jaysuk/RepRap-Huxley-Vector3D-Edition/Photos/RepRap Huxley V3D24 (21).jpg

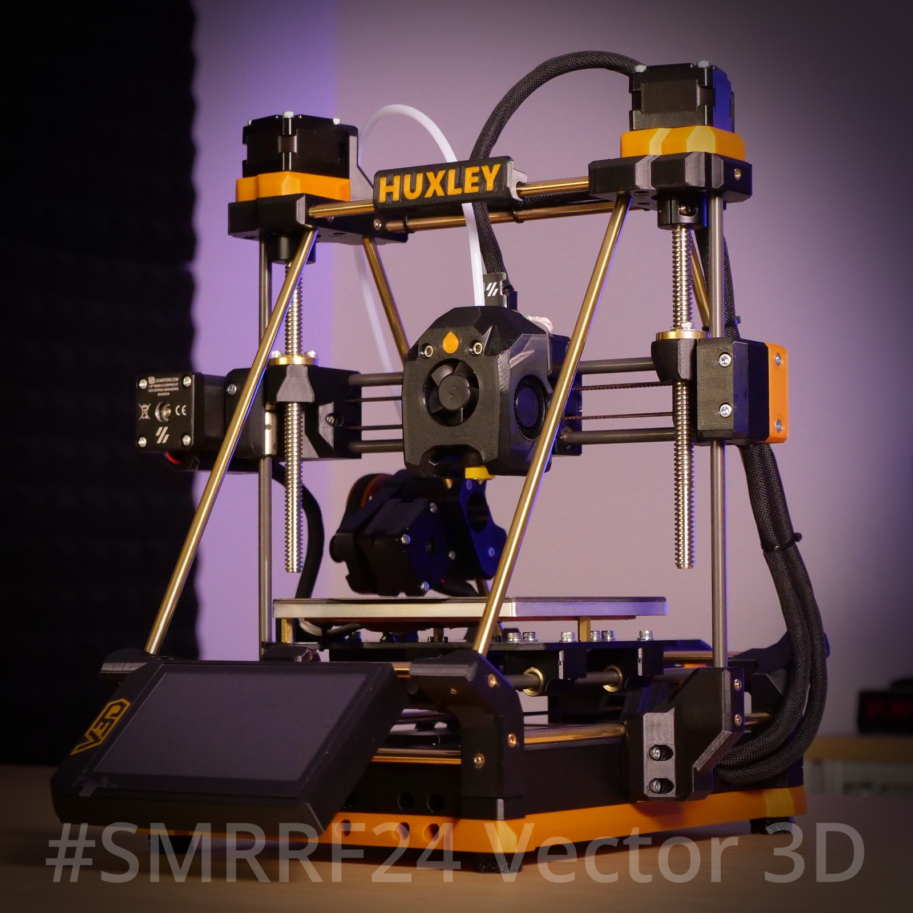
Photos/RepRap Huxley V3D24 (21).jpg
