jaysuk/RepRap-Huxley-Vector3D-Edition/Photos/RepRap Huxley V3D24 (27).jpg

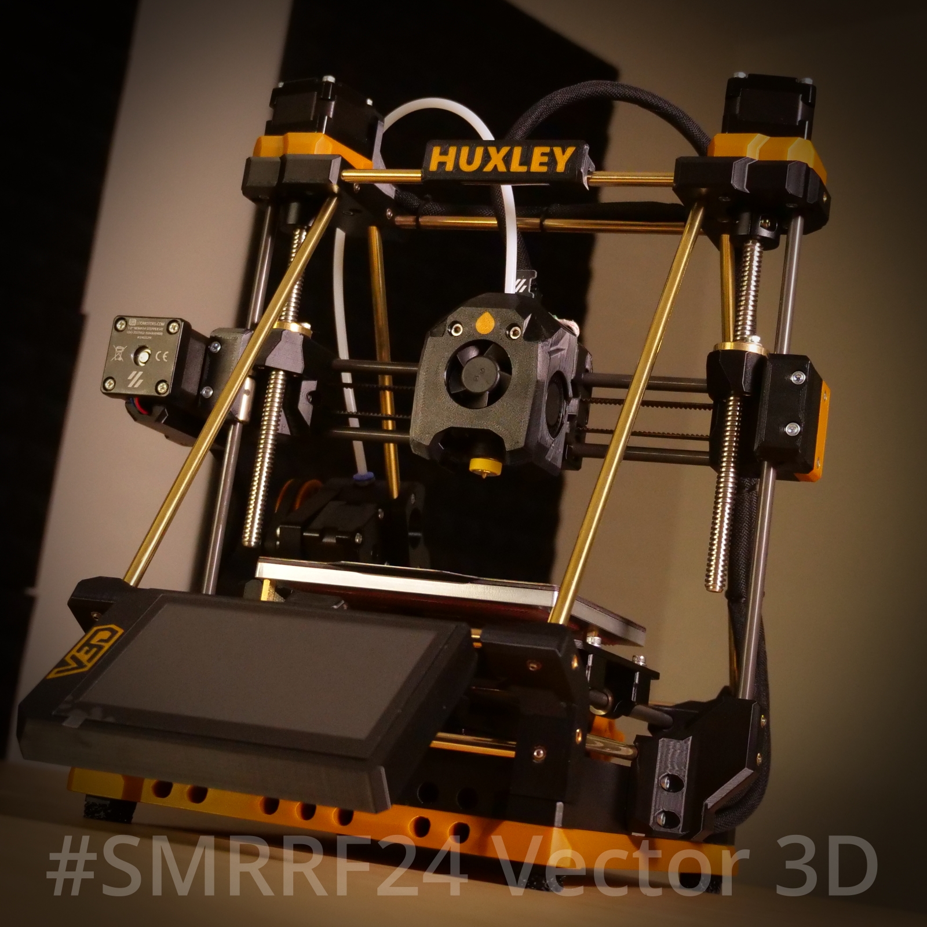
Photos/RepRap Huxley V3D24 (27).jpg
