jaysuk/RepRap-Huxley-Vector3D-Edition/Sourcing BOM/RepRap Huxley BOM GitHub V1.1.xlsx

Sheet: BOM
Index | Assembly | CAD Assembly | Name | Category | UoM | Qty | Link
1 | Printer Frame | Frame Vertex Front | Frame Vertex Front Left | Printed | pcs | 1 | N/A
2 | Printer Frame | Frame Vertex Front | Frame Vertex Front Right | Printed | pcs | 1 | N/A
3 | Printer Frame | Frame Vertex Front | Heat Set Insert, Brass, M3 x 5 x 4 (Vr) | Fastener | pcs | 12 | https://vector3d.shop/products/heat-set-insert-m3-voron
4 | Printer Frame | Frame Vertex Front | Set Screw, Hex Socket, Pointed Cone, Stainless Steel, DIN914, M3 x 6mm | Fastener | pcs | 12 | https://s.click.aliexpress.com/e/_oC1fNpn
5 | Printer Frame | Frame Top | Nema 14 Z Motor Spacer Left | Printed | pcs | 1 | N/A
6 | Printer Frame | Frame Top | Nema 14 Z Motor Spacer Right | Printed | pcs | 1 | N/A
7 | Printer Frame | Frame Top | Frame Vertex Top Left | Printed | pcs | 1 | N/A
8 | Printer Frame | Frame Top | Frame Vertex Top Right | Printed | pcs | 1 | N/A
9 | Printer Frame | Frame Top | Z Wire Cover Left | Printed | pcs | 1 | N/A
10 | Printer Frame | Frame Top | Z Wire Cover Right | Printed | pcs | 1 | N/A
11 | Printer Frame | Frame Top | Heat Set Insert, Brass, M3 x 5 x 4 (Vr) | Fastener | pcs | 12 | https://vector3d.shop/products/heat-set-insert-m3-voron
12 | Printer Frame | Frame Top | Set Screw, Hex Socket, Pointed Cone, Stainless Steel, DIN914, M3 x 6mm | Fastener | pcs | 12 | https://s.click.aliexpress.com/e/_oC1fNpn
13 | Printer Frame | Frame Top | Huxley Nema 14 Z Stepper Motor (see spec) | Bespoke | pcs | 2 | https://s.click.aliexpress.com/e/_oFytERf
14 | Printer Frame | Frame Top | Cable Sleeve, Self Closing, PET, Braided, 5mm | COTS | m | 0.6 | https://s.click.aliexpress.com/e/_oko25xx
15 | Printer Frame | Frame Top | Cable Sleeve, Self Closing, PET, Braided, 5mm | COTS | m | 0.4 | https://s.click.aliexpress.com/e/_oko25xx
16 | Printer Frame | Frame Top | TR8 Lead Screw, 150mm, 8mm Pitch, 2mm Lead, with nut | COTS Hardware | pcs | 2 | https://s.click.aliexpress.com/e/_olyJNbL
17 | Printer Frame | Frame Top | 5x8x25mm Lead Screw Motor Coupler, Black | COTS Hardware | pcs | 2 | https://s.click.aliexpress.com/e/_oDejujf
18 | Printer Frame | Frame Vertex Rear | Frame Vetex Rear Left | Printed | pcs | 1 | N/A
19 | Printer Frame | Frame Vertex Rear | Frame Vertex Rear Right | Printed | pcs | 1 | N/A
20 | Printer Frame | Frame Vertex Rear | Heat Set Insert, Brass, M3 x 5 x 4 (Vr) | Fastener | pcs | 12 | https://vector3d.shop/products/heat-set-insert-m3-voron
21 | Printer Frame | Frame Vertex Rear | Set Screw, Hex Socket, Pointed Cone, Stainless Steel, DIN914, M3 x 6mm | Fastener | pcs | 12 | https://s.click.aliexpress.com/e/_oC1fNpn
22 | Printer Frame | Frame Shafts | Brass rod, 6mm OD, 4mm ID, 176mm | Bespoke | pcs | 6 | https://s.click.aliexpress.com/e/_oCWMqFf
23 | Printer Frame | Frame Shafts | Brass rod, 6mm OD, 4mm ID, 233mm | Bespoke | pcs | 4 | https://s.click.aliexpress.com/e/_oCWMqFf
24 | Printer Frame | Frame Shafts | Brass rod, 6mm OD, 4mm ID, 240mm | Bespoke | pcs | 2 | https://s.click.aliexpress.com/e/_oCWMqFf
25 | Printer Frame | Linear Shafts | Hardened Steel Linear Shaft Rail, 6mm dia, 253mm | COTS Hardware | pcs | 2 | https://s.click.aliexpress.com/e/_oBieFgH
26 | Printer Frame | Linear Shafts | Hardened Steel Linear Shaft Rail, 6mm dia, 220mm | COTS Hardware | pcs | 2 | https://s.click.aliexpress.com/e/_oBieFgH
27 | Printer Frame | Linear Shafts | Hardened Steel Linear Shaft Rail, 6mm dia, 230mm | COTS Hardware | pcs | 2 | https://s.click.aliexpress.com/e/_oBieFgH
28 | Printer Frame | Name Plate | Huxley Name Plate | Printed | pcs | 1 | N/A
29 | Printer Frame | Name Plate | Heat Set Insert, Brass, M3 x 5 x 4 (Vr) | Fastener | pcs | 2 | https://vector3d.shop/products/heat-set-insert-m3-voron
30 | Printer Frame | Name Plate | Set Screw, Hex Socket, Pointed Cone, Stainless Steel, DIN914, M3 x 6mm | Fastener | pcs | 2 | https://s.click.aliexpress.com/e/_oC1fNpn
31 | Printer Frame | Frame Vertex Z Base | Frame Vertex Base Body | Printed | pcs | 2 | N/A
32 | Printer Frame | Frame Vertex Z Base | M3 x 16mm, BHCS, Zinc Plated | Fastener | pcs | 8 | 0
33 | Printer Frame | Frame Vertex Z Base | Heat Set Insert, Brass, M3 x 5 x 4 (Vr) | Fastener | pcs | 4 | https://vector3d.shop/products/heat-set-insert-m3-voron
34 | Printer Frame | Frame Vertex Z Base | Set Screw, Hex Socket, Pointed Cone, Stainless Steel, DIN914, M3 x 6mm | Fastener | pcs | 4 | https://s.click.aliexpress.com/e/_oC1fNpn
35 | Y Axis | Y Bed Assembly | Bed Carriage Plate, Aluminium 6061, Black Matte Anodised, 3mm | Bespoke | pcs | 1 | LDO
36 | Y Axis | Y Bed Assembly | Bed Bearing Holder | Printed | pcs | 4 | N/A
37 | Y Axis | Y Bed Assembly | Bed Bearing Holder Spacer | Printed | pcs | 4 | N/A
38 | Y Axis | Y Bed Assembly | M3 x 16mm, SHCS, Zinc Plated | Fastener | pcs | 12 | Not Applicable
39 | Y Axis | Y Bed Assembly | M3 Washer, Form A, Zinc Plated | Fastener | pcs | 12 | Not Applicable
40 | Y Axis | Y Bed Assembly | Heat Set Insert, Brass, M3 x 5 x 4 (Vr) | Fastener | pcs | 12 | https://vector3d.shop/products/heat-set-insert-m3-voron
41 | Y Axis | Y Bed Assembly | LM6UU Bearing, Graphite Copper, 6x12x19mm | COTS Hardware | pcs | 4 | https://s.click.aliexpress.com/e/_on7sy4t
42 | Y Axis | Y Bed Assembly | Hex Standoff, Female-Female, Brass, M3 x 10mm | Fastener | pcs | 3 | https://s.click.aliexpress.com/e/_ooBX8il
43 | Y Axis | Y Bed Assembly | M3 x 8mm, SHCS, Zinc Plated | Fastener | pcs | 3 | Not Applicable
44 | Y Axis | Y Bed Assembly | M3 x 8mm, BHCS, Zinc Plated | Fastener | pcs | 3 | Not Applicable
45 | Y Axis | Y Bed Assembly | M3 Washer, Form A, Zinc Plated | Fastener | pcs | 3 | Not Applicable
46 | Y Axis | Y Bed Assembly | 120x120x6mm Bed Plate (Voron v0.1) | COTS Hardware | pcs | 1 | LDO
47 | Y Axis | Y Bed Assembly | 100x100mm, Silicone Heater, 60W, 24V, NTC 100k, with adhesive | COTS Electrical | pcs | 1 | https://s.click.aliexpress.com/e/_oCzqo97
48 | Y Axis | Y Bed Assembly | 120x120mm Spring Steel Print Surface with adhesive magnet | COTS Hardware | pcs | 1 | LDO
49 | Y Axis | Y Bed Assembly | Y Belt Holder | Printed | pcs | 1 | N/A
50 | Y Axis | Y Bed Assembly | Y Belt Tensioner | Printed | pcs | 1 | N/A
51 | Y Axis | Y Bed Assembly | M3 x 8mm, SHCS, Zinc Plated | Fastener | pcs | 3 | Not Applicable
52 | Y Axis | Y Bed Assembly | M3 x 12mm, SHCS, Zinc Plated | Fastener | pcs | 2 | Not Applicable
53 | Y Axis | Y Bed Assembly | M3 x 30mm, SHCS, Zinc Plated | Fastener | pcs | 1 | Not Applicable
54 | Y Axis | Y Bed Assembly | M3 Nut, Nyloc, Zinc Plated | Fastener | pcs | 3 | Not Applicable
55 | Y Axis | Y Bed Assembly | 7x7mm Drag Chain Link | COTS Hardware | pcs | 3 | https://s.click.aliexpress.com/e/_oFumcM1
56 | Y Axis | Y Bed Assembly | Y Drag Chain End Bed | Printed | pcs | 1 | N/A
57 | Y Axis | Y Bed Assembly | M3 x 8mm, SHCS, Zinc Plated | Fastener | pcs | 2 | Not Applicable
58 | Y Axis | Chain End B | Y Drag Chain End Frame | Printed | pcs | 1 | N/A
59 | Y Axis | Chain End B | 7x7mm Drag Chain Link | COTS Hardware | pcs | 5 | https://s.click.aliexpress.com/e/_oFumcM1
60 | Y Axis | Chain End B | Heat Set Insert, Brass, M3 x 5 x 4 (Vr) | Fastener | pcs | 1 | https://vector3d.shop/products/heat-set-insert-m3-voron
61 | Y Axis | Chain End B | Set Screw, Hex Socket, Pointed Cone, Stainless Steel, DIN914, M3 x 6mm | Fastener | pcs | 1 | https://s.click.aliexpress.com/e/_oC1fNpn
62 | Y Axis | Y Motor | Huxley Nema 14 Y Stepper Motor (see spec) | Bespoke | pcs | 1 | https://s.click.aliexpress.com/e/_oDsiqIV
63 | Y Axis | Y Motor | Pulley, 20T, Bore 5mm, Belt Width 6mm, Black | COTS Hardware | pcs | 1 | https://s.click.aliexpress.com/e/_oFh7rDn
64 | Y Axis | Y Motor | Belt, 6mm, Gates 2GT | COTS Hardware | m | 0.642 | https://s.click.aliexpress.com/e/_oFIdbGl
65 | Y Axis | Y Motor | Heat Set Insert, Brass, M3 x 5 x 4 (Vr) | Fastener | pcs | 6 | https://vector3d.shop/products/heat-set-insert-m3-voron
66 | Y Axis | Y Motor | Set Screw, Hex Socket, Pointed Cone, Stainless Steel, DIN914, M3 x 6mm | Fastener | pcs | 2 | https://s.click.aliexpress.com/e/_oC1fNpn
67 | Y Axis | Y Motor | M3 x 16mm, SHCS, Zinc Plated | Fastener | pcs | 5 | Not Applicable
68 | Y Axis | Y Motor | M3 x 8mm, SHCS, Zinc Plated | Fastener | pcs | 3 | Not Applicable
69 | Y Axis | Y Motor | Y Motor Mount Front | Printed | pcs | 1 | N/A
70 | Y Axis | Y Motor | Y Motor Mount Back | Printed | pcs | 1 | N/A
71 | Y Axis | Y Motor | Y Motor Mount Cover | Printed | pcs | 1 | N/A
72 | Y Axis | Y Motor | Y Motor Cable Guide | Printed | pcs | 1 | N/A
73 | Y Axis | Y Idler | Y Idler Body | Printed | pcs | 1 | N/A
74 | Y Axis | Y Idler | MF115ZZ 5x11x4mm Flange Bearing | COTS Hardware | pcs | 2 | https://www.aliexpress.com/item/1005008082332408.html?
75 | Y Axis | Y Idler | Heat Set Insert, Brass, M3 x 5 x 4 (Vr) | Fastener | pcs | 2 | https://vector3d.shop/products/heat-set-insert-m3-voron
76 | Y Axis | Y Idler | Set Screw, Hex Socket, Pointed Cone, Stainless Steel, DIN914, M3 x 6mm | Fastener | pcs | 2 | https://s.click.aliexpress.com/e/_oC1fNpn
77 | Y Axis | Y Idler | M5 x 20mm, BHCS, Zinc Plated | Fastener | pcs | 1 | Not Applicable
78 | X Axis | X End, Motor | X End Motor Body | Printed | pcs | 1 | N/A
79 | X Axis | X End, Motor | M3 x 30mm, SHCS, Zinc Plated | Fastener | pcs | 1 | Not Applicable
80 | X Axis | X End, Motor | M3 Nut, Hex, Zinc Plated | Fastener | pcs | 1 | Not Applicable
81 | X Axis | X End, Motor | Huxley Nema 14 X Stepper Motor (see spec) | COTS Electrical | pcs | 1 | https://s.click.aliexpress.com/e/_oDsiqIV
82 | X Axis | X End, Motor | Pulley, 20T, Bore 5mm, Belt Width 6mm, Black | COTS Hardware | pcs | 1 | https://s.click.aliexpress.com/e/_oFh7rDn
83 | X Axis | X End, Motor | M3 x 16mm, SHCS, Zinc Plated | Fastener | pcs | 4 | Not Applicable
84 | X Axis | X End, Motor | Cable Sleeve, Self Closing, PET, Braided, 5mm | COTS Hardware | m | 0.3 | https://s.click.aliexpress.com/e/_oko25xx
85 | X Axis | X End, Motor | X Motor Cable Cover | Printed | pcs | 1 | N/A
86 | X Axis | X End, Motor | M3 x 8mm, SHCS, Zinc Plated | Fastener | pcs | 2 | Not Applicable
87 | X Axis | X End, Motor | X End Bearing Cover Left | Printed | pcs | 1 | N/A
88 | X Axis | X End, Motor | LM6UU Bearing, Graphite Copper, 6x12x19mm | COTS Hardware | pcs | 2 | https://s.click.aliexpress.com/e/_on7sy4t
89 | X Axis | X End, Motor | M3 x 20mm, SHCS, Zinc Plated | Fastener | pcs | 2 | Not Applicable
90 | X Axis | X End, Motor | Lead Screw Nut, TR8, Pitch 2mm (included with lead screw) | COTS Hardware | pcs | 1 | #N/A
91 | X Axis | X End, Motor | M3 x 20mm, SHCS, Zinc Plated | Fastener | pcs | 2 | Not Applicable
92 | X Axis | X End, Motor | Heat Set Insert, Brass, M3 x 5 x 4 (Vr) | Fastener | pcs | 9 | https://vector3d.shop/products/heat-set-insert-m3-voron
93 | X Axis | X End, Motor | Set Screw, Hex Socket, Pointed Cone, Stainless Steel, DIN914, M3 x 6mm | Fastener | pcs | 2 | https://s.click.aliexpress.com/e/_oC1fNpn
94 | X Axis | X End, Motor | Belt, 6mm, Gates 2GT | COTS Hardware | m | 0.56 | https://s.click.aliexpress.com/e/_oFIdbGl
95 | X Axis | X End, Idler | X End Idler Body | Printed | pcs | 1 | N/A
96 | X Axis | X End, Idler | X End Bearing Cover Right | Printed | pcs | 1 | N/A
97 | X Axis | X End, Idler | LM6UU Bearing, Graphite Copper, 6x12x19mm | COTS Hardware | pcs | 2 | https://s.click.aliexpress.com/e/_on7sy4t
98 | X Axis | X End, Idler | M3 x 20mm, SHCS, Zinc Plated | Fastener | pcs | 2 | Not Applicable
99 | X Axis | X End, Idler | Lead Screw Nut, TR8, Pitch 2mm (included with lead screw) | COTS Hardware | pcs | 1 | #N/A
100 | X Axis | X End, Idler | M3 x 20mm, SHCS, Zinc Plated | Fastener | pcs | 2 | Not Applicable
101 | X Axis | X End, Idler | X End Idler Mount | Printed | pcs | 1 | N/A
102 | X Axis | X End, Idler | MF115ZZ 5x11x4mm Flange Bearing | COTS Hardware | pcs | 2 | https://www.aliexpress.com/item/1005008082332408.html?
103 | X Axis | X End, Idler | M5 x 16mm, BHCS, Zinc Plated | Fastener | pcs | 1 | Not Applicable
104 | X Axis | X End, Idler | Heat Set Insert, Brass, M3 x 5 x 4 (Vr) | Fastener | pcs | 8 | https://vector3d.shop/products/heat-set-insert-m3-voron
105 | X Axis | X End, Idler | Set Screw, Hex Socket, Pointed Cone, Stainless Steel, DIN914, M3 x 6mm | Fastener | pcs | 2 | https://s.click.aliexpress.com/e/_oC1fNpn
106 | X Axis | X Carriage | X Carriage Body | Printed | pcs | 1 | N/A
107 | X Axis | X Carriage | X Carriage Lower Bearing Clamp | Printed | pcs | 1 | N/A
108 | X Axis | X Carriage | X Carraige Upper Bearing Clamp | Printed | pcs | 1 | N/A
109 | X Axis | X Carriage | LM6LUU Bearing, Graphite Copper, 6x12x35mm | COTS Hardware | pcs | 1 | https://s.click.aliexpress.com/e/_olb0Hwv
110 | X Axis | X Carriage | LM6UU Bearing, Graphite Copper, 6x12x19mm | COTS Hardware | pcs | 4 | https://s.click.aliexpress.com/e/_on7sy4t
111 | X Axis | X Carriage | M3 Nut, Square, Zinc Plated | COTS Hardware | pcs | 4 | https://s.click.aliexpress.com/e/_olgOr77
112 | X Axis | X Carriage | M3 x 8mm, SHCS, Zinc Plated | Fastener | pcs | 4 | Not Applicable
113 | X Axis | X Carriage | M3 x 12mm, SHCS, Zinc Plated | Fastener | pcs | 4 | Not Applicable
114 | X Axis | X Carriage | Heat Set Insert, Brass, M3 x 5 x 4 (Vr) | Fastener | pcs | 6 | https://vector3d.shop/products/heat-set-insert-m3-voron
115 | X Axis | ToolHead | Huxley Mini SB Bowden Cowling | Printed | pcs | 1 | N/A
116 | X Axis | ToolHead | PTFE Tube, 4mm OD, 2mm ID, 32mm | COTS Hardware | m | 0.032 | https://s.click.aliexpress.com/e/_omdtdiv
117 | X Axis | ToolHead | Poke Probe | Printed | pcs | 1 | N/A
118 | X Axis | ToolHead | Poke Spacer | Printed | pcs | 1 | N/A
119 | X Axis | ToolHead | Set Screw, Hex Socket, Flat, Stainless Steel, DIN914, M3 x 4mm | Fastener | pcs | 4 | https://s.click.aliexpress.com/e/_oDxamSl
120 | X Axis | ToolHead | Wire, PTFE, 24AWG, 100mm | COTS Electrical | m | 0.1 | https://s.click.aliexpress.com/e/_opigOOV
121 | X Axis | ToolHead | MiniSB Bowden Toolhead PCB | COTS Electrical | pcs | 1 | Custom PCB
122 | X Axis | ToolHead | MiniSB Umbilical Wire Harness (see Specs) | Bespoke | pcs | 1 | Custom Wire Harness
123 | X Axis | ToolHead | M2 x 10mm, SHCS, Self Tapping | Fastener | pcs | 2 | https://s.click.aliexpress.com/e/_oocZ1fT
124 | X Axis | ToolHead | M3 x 35mm, BHCS, Zinc Plated | Fastener | pcs | 2 | Not Applicable
125 | X Axis | ToolHead | ECAS04 Bowden Collet | COTS Hardware | pcs | 1 | https://s.click.aliexpress.com/e/_oCLUYq9
126 | X Axis | ToolHead | 3010 DC Axial Fan (voron v0 spec) | COTS Electrical | pcs | 1 | https://s.click.aliexpress.com/e/_onlr0cv
127 | X Axis | ToolHead | 3010 DC Radial Blower Fan (voron v0 spec) | COTS Electrical | pcs | 2 | https://s.click.aliexpress.com/e/_onlr0cv
128 | X Axis | ToolHead | TZ-V6-2.0 | COTS Electrical | pcs | 1 | 0
129 | Extruder | Mini-14 Mirrored | Mini14 Main Body Mid Section | Printed | pcs | 1 | N/A
130 | Extruder | Mini-14 Mirrored | Mini14 Main Body End Plate | Printed | pcs | 1 | N/A
131 | Extruder | Mini-14 Mirrored | Mini14 Main Body Motor Plate | Printed | pcs | 1 | N/A
132 | Extruder | Mini-14 Mirrored | Mini14 Main Body Clamp | Printed | pcs | 1 | N/A
133 | Extruder | Mini-14 Mirrored | Huxley Nema 14 E Stepper Motor (see spec) | Bespoke | pcs | 1 | https://s.click.aliexpress.com/e/_oFytERf
134 | Extruder | Mini-14 Mirrored | Pulley, 16T, Bore 5mm, Belt Width 6mm, Black | COTS Hardware | pcs | 2 | https://s.click.aliexpress.com/e/_oodzRYH
135 | Extruder | Mini-14 Mirrored | M3 x 12mm, BHCS, Zinc Plated | Fastener | pcs | 2 | Not Applicable
136 | Extruder | Mini-14 Mirrored | M3 x 10mm, SHCS, Zinc Plated | Fastener | pcs | 1 | Not Applicable
137 | Extruder | Mini-14 Mirrored | M3 x 30mm, SHCS, Zinc Plated | Fastener | pcs | 4 | Not Applicable
138 | Extruder | Mini-14 Mirrored | ECAS04 Bowden Collet | COTS Hardware | pcs | 1 | https://s.click.aliexpress.com/e/_oCLUYq9
139 | Extruder | Mini-14 Mirrored | Heat Set Insert, Brass, M3 x 5 x 4 (Vr) | Fastener | pcs | 7 | https://vector3d.shop/products/heat-set-insert-m3-voron
140 | Extruder | Mini-14 Mirrored | Mini14 Latch | Printed | pcs | 1 | N/A
141 | Extruder | Mini-14 Mirrored | Mini14 Guidler | Printed | pcs | 1 | N/A
142 | Extruder | Mini-14 Mirrored | Mini14 Shuttle | Printed | pcs | 1 | N/A
143 | Extruder | Mini-14 Mirrored | PTFE Tube, 4mm OD, 2mm ID, 32mm | COTS Hardware | m | 0.032 | https://s.click.aliexpress.com/e/_omdtdiv
144 | Extruder | Mini-14 Mirrored | Bondtech Driver Gear and Idler | COTS Hardware | pcs | 1 | https://s.click.aliexpress.com/e/_oECa5HP
145 | Extruder | Mini-14 Mirrored | Bondtech Extruder Spring Set | COTS Hardware | pcs | 1 | https://s.click.aliexpress.com/e/_ontUa5L
146 | Extruder | Mini-14 Mirrored | Bondtech Extruder Shaft | COTS Hardware | pcs | 1 | https://s.click.aliexpress.com/e/_o2aOLXF
147 | Extruder | Mini-14 Mirrored | Mini14 Guidler | Printed | pcs | 1 | N/A
148 | Extruder | Mini-14 Mirrored | M3 x 8mm, SHCS, Zinc Plated | Fastener | pcs | 2 | Not Applicable
149 | Extruder | Mini-14 Mirrored | GT2 Belt, Loop, 6mm width, 150mm | COTS Hardware | pcs | 1 | https://s.click.aliexpress.com/e/_olMfmXP
150 | Extruder | Mini-14 Mirrored | 64T Front Pullet Gear | Printed | pcs | 1 | N/A
151 | Extruder | Mini-14 Mirrored | Set Screw, Hex Socket, Pointed Cone, Stainless Steel, DIN914, M3 x 6mm | Fastener | pcs | 4 | https://s.click.aliexpress.com/e/_oC1fNpn
152 | Extruder | Mini-14 Mirrored | D-Shaft, Steel, 5mm dia, 50mm Length | COTS Hardware | pcs | 1 | https://s.click.aliexpress.com/e/_oDKDjFb
153 | Extruder | Mini-14 Mirrored | Spacer, 3mm | Printed | pcs | 1 | N/A
154 | Extruder | Mini-14 Mirrored | Spacer, 3.8mm | Printed | pcs | 1 | N/A
155 | Extruder | Mini-14 Mirrored | F6952RS, Flange Bearing, 5x13x4mm | COTS Hardware | pcs | 2 | https://s.click.aliexpress.com/e/_okQcUI9
156 | Extruder | Mini-14 Mirrored | Cable Sleeve, Self Closing, PET, Braided, 5mm | COTS Hardware | m | 0.2 | https://s.click.aliexpress.com/e/_oko25xx
157 | Electronics Enclosure | Electronics Enclosure | Enclosure Upper | Printed | pcs | 1 | N/A
158 | Electronics Enclosure | Electronics Enclosure | Heat Set Insert, Brass, M3 x 5 x 4 (Vr) | Fastener | pcs | 8 | https://vector3d.shop/products/heat-set-insert-m3-voron
159 | Electronics Enclosure | Electronics Enclosure | Enclosure Lower | Printed | pcs | 1 | N/A
160 | Electronics Enclosure | Electronics Enclosure | M3 x 12mm, SHCS, Zinc Plated | Fastener | pcs | 8 | Not Applicable
161 | Electronics Enclosure | Electronics Enclosure | Y Motor Passthough Upper | Printed | pcs | 1 | N/A
162 | Electronics Enclosure | Electronics Enclosure | Y Motor Passthough Lower | Printed | pcs | 1 | N/A
163 | Electronics Enclosure | Electronics Enclosure | Extruder Passthough | Printed | pcs | 1 | N/A
164 | Electronics Enclosure | Electronics Enclosure | Z Motor Passthrough | Printed | pcs | 1 | N/A
165 | Electronics Enclosure | Electronics Enclosure | Bed Passthrough | Printed | pcs | 1 | N/A
166 | Electronics Enclosure | Electronics Enclosure | M3 x 12mm, SHCS, Zinc Plated | Fastener | pcs | 7 | Not Applicable
167 | Electronics Enclosure | Electronics Enclosure | Hex Foot | Printed | pcs | 4 | N/A
168 | Electronics Enclosure | Electronics Enclosure | M3 x 12mm, SHCS, Zinc Plated | Fastener | pcs | 4 | Not Applicable
169 | Electronics Enclosure | Electronics Enclosure | 4010 Radial Fan, 24V | COTS Electrical | pcs | 2 | https://s.click.aliexpress.com/e/_oFncEMt
170 | Electronics Enclosure | Electronics Enclosure | M3 x 6mm, SHCS, Self Tapping | Fastener | pcs | 8 | Not Applicable
171 | Electronics Enclosure | Electronics Enclosure | 4010 Axial Fan, 24V | COTS Electrical | pcs | 1 | https://s.click.aliexpress.com/e/_oFncEMt
172 | Electronics Enclosure | Electronics Enclosure | M3 x 10mm, SHCS, Self Tapping | Fastener | pcs | 4 | https://s.click.aliexpress.com/e/_ooSIUhT
173 | Electronics Enclosure | Electronics Enclosure | Rocker Switch, KCD1, 4 Pin, Black | COTS Electrical | pcs | 1 | https://s.click.aliexpress.com/e/_okNm3VJ
174 | Electronics Enclosure | Electronics Enclosure | Spade Terminal, Female | COTS Electrical | pcs | 4 | https://s.click.aliexpress.com/e/_oCGcb8d
175 | Electronics Enclosure | Electronics Enclosure | Power Connector, KYCON, KPJX-PM-4 | COTS Electrical | pcs | 1 | https://www.mouser.co.uk/ProductDetail/Kycon/KPJX-PM-4S?qs=zorda86t5M%2Fdp%252BTtr6by2g%3D%3D
176 | Electronics Enclosure | Electronics Enclosure | ST2.9 x 13 Screw | Fastener | pcs | 2 | https://s.click.aliexpress.com/e/_o2DYvLb
177 | Electronics Enclosure | Electronics Enclosure | RJ45 Keystone | COTS Electrical | pcs | 1 | https://s.click.aliexpress.com/e/_olKKrjj
178 | Electronics Enclosure | Electronics Enclosure | Ethernet Cable, Flexible, 200mm | COTS Electrical | pcs | 1 | https://s.click.aliexpress.com/e/_oFH9p61
179 | Electronics Enclosure | Electronics Enclosure | JST XH 5-way Hub | COTS Electrical | pcs | 1 | Custom PCB
180 | Electronics Enclosure | Electronics Enclosure | M3 x 8mm, SHCS, Self Tapping | Fastener | pcs | 2 | https://s.click.aliexpress.com/e/_oE11vDB
181 | Electronics Enclosure | Electronics Enclosure | BigtreeTech SKR Pico | COTS Electrical | pcs | 1 | BigTreeTech
183 | Electronics Enclosure | Electronics Enclosure | Raspberry Pi Zero 2W | COTS Electrical | pcs | 1 | https://thepihut.com/products/raspberry-pi-zero-2?variant=41181426909379
184 | Electronics Enclosure | Electronics Enclosure | Connector Cover | Printed | pcs | 1 | N/A
185 | Electronics Enclosure | Electronics Enclosure | M2 x 6mm, SHCS, Self Tapping | Fastener | pcs | 2 | https://s.click.aliexpress.com/e/_oocZ1fT
0 | Electronics Enclosure | Electronics Enclosure | Switch Harness (See Specs) | Bespoke | pcs | 1 | #N/A
0 | Electronics Enclosure | Electronics Enclosure | Power Harness 1 (See Specs) | Bespoke | pcs | 1 | #N/A
0 | Electronics Enclosure | Electronics Enclosure | Power Harness 2 (See Specs) | Bespoke | pcs | 1 | #N/A
186 | Power | Power Supply | Power Supply, External, EA11811k-240 | COTS Electrical | pcs | 1 | 0
187 | Toolkit | Toolkit | 1.5mm Hex for M3 set screws | COTS Hardware | pcs | 1 | #N/A
188 | Toolkit | Toolkit | 2.5mm Hex for M3 SHCS | COTS Hardware | pcs | 1 | #N/A
189 | Toolkit | Toolkit | 2.0mm Hex for M3 BHCS | COTS Hardware | pcs | 1 | #N/A
190 | Toolkit | Toolkit | Locktite | COTS Hardware | pcs | 1 | #N/A
191 | Toolkit | Toolkit | Steel Wool | COTS Hardware | pcs | 1 | #N/A
192 | Toolkit | Toolkit | Zip Ties, 2.5 x 100mm | COTS Hardware | pcs | 100 | #N/A

Sheet: Custom Specifications
Name | Model | Face | Body Length mm (approx) | Wire Length mm | Connector | Shaft Diameter | Shaft Length (from mounting face) | Shaft Type | Step Angle | Wire Connection
Z Left Motor | 14HS11-1004S | Nema14 | 26.6 | 480 | JST XH 4P | 5 | 24 | D | 1.8 | Direct into Body
Z Right Motor | 14HS11-1004S | Nema14 | 26.6 | 605 | JST XH 4P | 5 | 24 | D | 1.8 | Direct into Body
X Motor | 35STH52-1504AH | Nema14 | 50.8 | 450 | JST XH 4P | 5 | 19 (+5/ -0) | D | 1.8 | Direct into Body
Y Motor | 35STH52-1504AH | Nema14 | 50.8 | 200 | JST XH 4P | 5 | 19 (+5/ -0) | D | 1.8 | Direct into Body
E0 Motor | 14HS11-1004S | Nema14 | 26.6 | 250 | JST XH 4P | 5 | 18 (+8/-0) | D | 1.8 | Direct into Body
Harness | End A | Pin Number A | Pin Name | Function | Length (mm) | Wire Gauge | Wire Type | Wire Colour | EndB
MiniSB Umbilical | Microfit 3.0 2x4 | 1 | 24V | 24V Power | 740 | 24 | PTFE/FEP | Black | Ferrule
MiniSB Umbilical | Microfit 3.0 2x4 | 2 | PCF | Part Cooling Fan | 700 | 24 | PTFE/FEP | Black | JST XH 2P
MiniSB Umbilical | Microfit 3.0 2x4 | 3 | GND | Ground | 740 | 24 | PTFE/FEP | Black | Ferrule
MiniSB Umbilical | Microfit 3.0 2x4 | 4 | TH0 | Thermistor | 760 | 24 | PTFE/FEP | Black | JST XH 2P
MiniSB Umbilical | Microfit 3.0 2x4 | 5 | HEF | Hotend Fan | 700 | 24 | PTFE/FEP | Black | JST XH 2P
MiniSB Umbilical | Microfit 3.0 2x4 | 6 | 5V | 5V Power | 760 | 24 | PTFE/FEP | Black | cut wire/not used
MiniSB Umbilical | Microfit 3.0 2x4 | 7 | LED | LED Signal | 760 | 24 | PTFE/FEP | Black | cut wire/not used
MiniSB Umbilical | Microfit 3.0 2x4 | 8 | HE0 | Hotend | 740 | 24 | PTFE/FEP | Black | Ferrule
Power 1 | KPJX-PM-4 | 1 | +VE | 24V Power | 220 | 18 | PVC | Red | Stripped 10mm for WAGO
Power 1 | KPJX-PM-4 | 2 | -VE | Ground | 185 | 18 | PVC | Black | Stripped 10mm for WAGO
Power 1 | KPJX-PM-4 | 3 | -VE | Ground | 185 | 18 | PVC | Black | Stripped 10mm for WAGO
Power 1 | KPJX-PM-4 | 4 | +VE | 24V Power | 220 | 18 | PVC | Red | Stripped 10mm for WAGO
Power 2 | Stripped 10mm for WAGO | 1 | -VE | Ground | 115 | 18 | PVC | Black | Ferrule
Switch | Switch | 1 | +VE | 24V Power | 70 | 18 | PVC | Red | Stripped 10mm for WAGO
Switch | Switch | 2 | +VE | 24V Power | 150 | 18 | PVC | Red | Ferrule
Name | Thickness (mm) | Material | Finish | Width (mm) | Length (mm)
Bed Carriage Plate | 3 | 6061 Aluminium | Anodised Black | 158 | 120
