jaysuk/RepRap-Huxley-Vector3D-Edition/Full CAD/RepRapPro Huxley Assembled.step

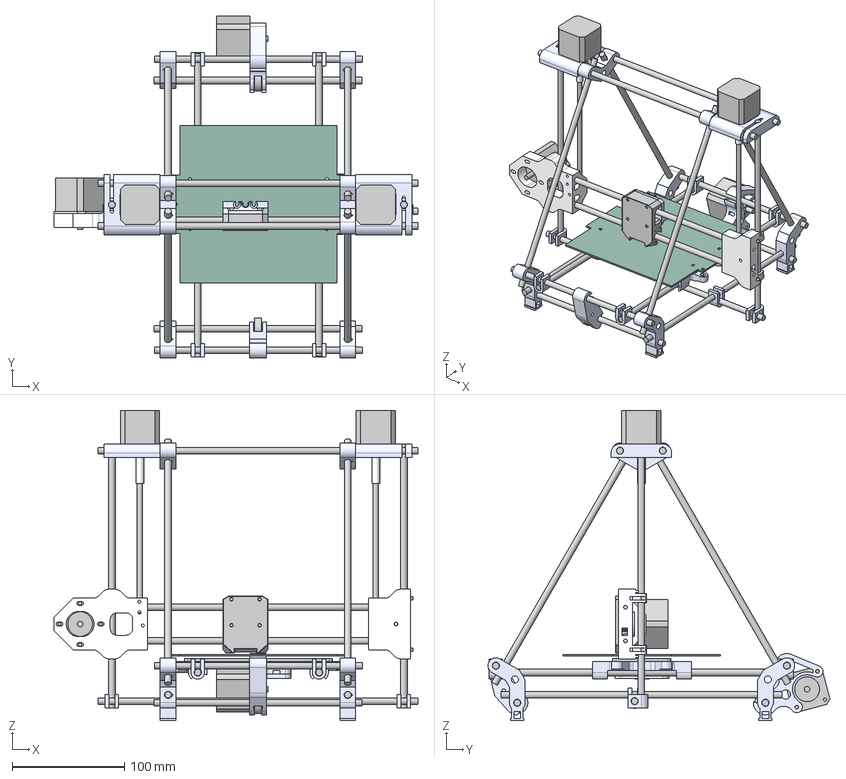
[picture p29: CAD file, 2026-03-26]
Full CAD/RepRapPro Huxley Assembled.step
324.0 x 304.5 x 276.4 mm
frame-vertex x 2
frame-vertex-foot x 4
bar-clamp x 8
626 Bearing x 2
z-motor-bracket x 2
Y Frog
bearing-holder-float
bearing-holder-fixed
y-belt-clamp x 2
y-belt-tensioner
Nema14 x 4
y-motor-bracket
y-idler-bracket
623 Bearing x 2
x-idler-bracket
x-motor-bracket
nozzle-mounting
idler-cover
x-carriage
PolyTube x 2
M5 165mm x 2
Huxley PCB Heater
