jaysuk/RepRap-Huxley-Vector3D-Edition/Drawings 2D/Y Axis Bed Plate Drawing v3.pdf

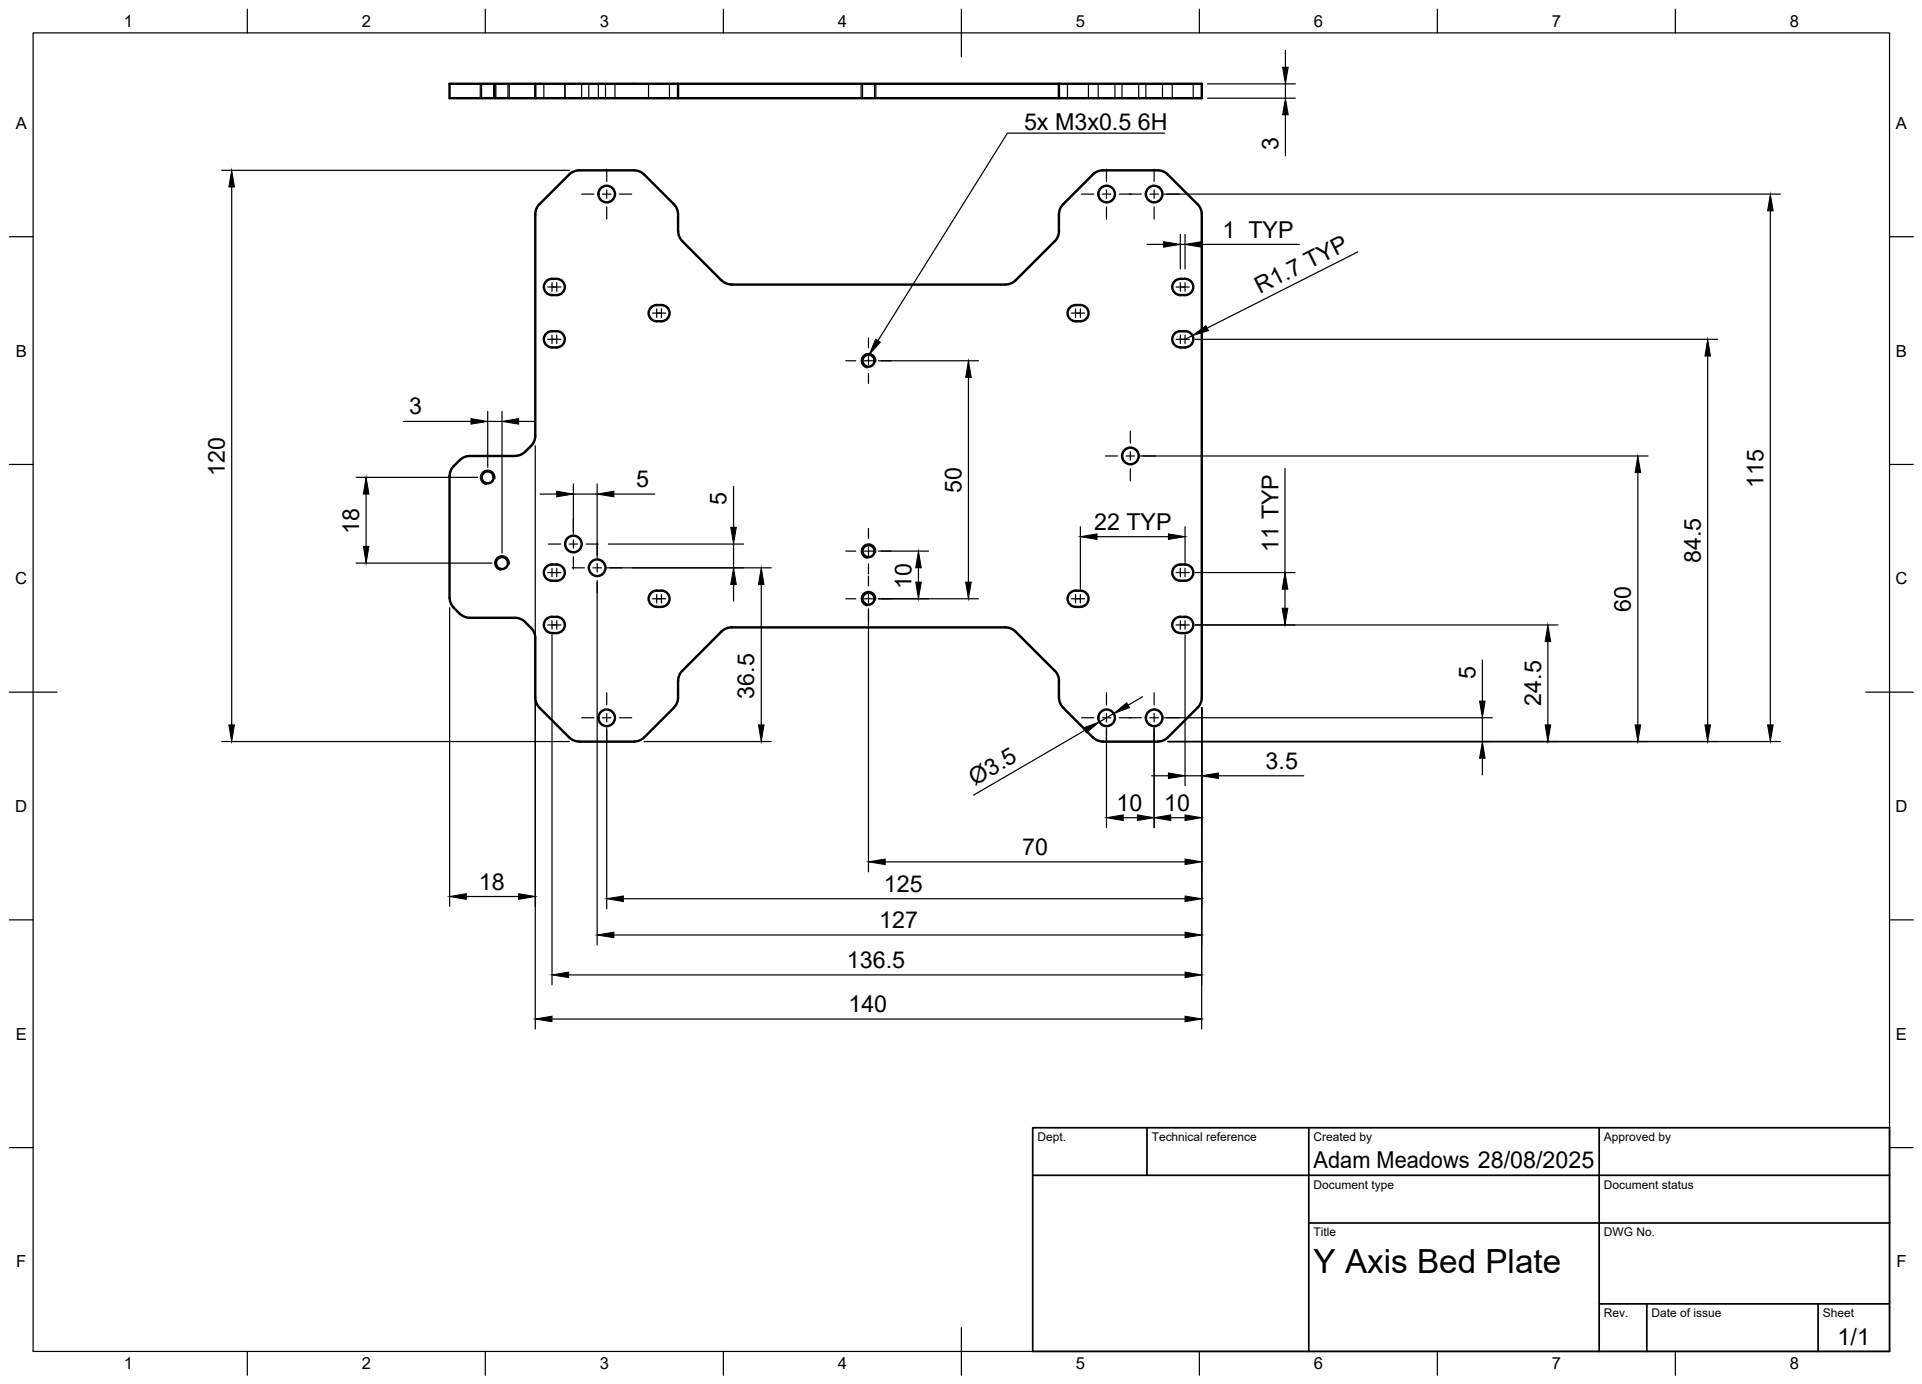
[picture p30: page 1]
Title; DWG No.; Rev.; Date of issue; Sheet; 5 24.5 60 84.5 11 TYP 22 TYP 115; R1.7 TYP 1 TYP

Dept. | Technical reference | Created by Adam Meadows 28/08/2025 | Approved by

Document type | Document status

Y Axis Bed Plate
