jaysuk/RepRap-Huxley-Vector3D-Edition/Firmware/printer.cfg

# This file contains common pin mappings for the BIGTREETECH Manta M5P
# To use this config, the firmware should be compiled for the
# STM32G0B1 with a "8KiB bootloader" "8 MHz crystal"
# and "USB (on PA11/PA12)" or "CAN bus (on PD0/PD1)".

# See docs/Config_Reference.md for a description of parameters.


[mcu]
serial: /dev/serial/by-id/usb-Klipper_stm32g0b1xx_290045001950425938323120-if00

[printer]
kinematics: cartesian
max_velocity: 300
max_accel: 3000
max_z_velocity: 5
max_z_accel: 100


[stepper_x]
step_pin: PC8
dir_pin: !PC9
enable_pin: !PA15
microsteps: 16
rotation_distance: 40
endstop_pin: ^PD3
position_endstop: 0
position_max: 120
homing_speed: 50

[tmc2209 stepper_x]
uart_pin: PD9
diag_pin: PD3
interpolate: False
run_current: 0.500 #1A Max
stealthchop_threshold: 0
driver_SGTHRS: 255  #sensorless homing sensitivity 0-255 (255 = most sensitive)

[stepper_y]
step_pin: PA10
dir_pin: !PA14
enable_pin: !PA13
microsteps: 16
rotation_distance: 40
endstop_pin: ^PD2
position_endstop: 0
position_max: 120
homing_speed: 50

[tmc2209 stepper_y]
uart_pin: PD8
diag_pin: PD2
interpolate: False
run_current: 0.500 #1A MAX
stealthchop_threshold: 0
driver_SGTHRS: 255  #sensorless homing sensitivity 0-255 (255 = most sensitive)

[stepper_z]
step_pin: PC6
dir_pin: PC7
enable_pin: !PA9
microsteps: 16
rotation_distance: 8
endstop_pin: probe:z_virtual_endstop
#position_endstop: 0.0
position_max: 70

[tmc2209 stepper_z]
uart_pin: PB10
run_current: 0.200 #0.7A Max
stealthchop_threshold: 0
interpolate: False
diag_pin: PC3

[extruder]
step_pin: PB12
dir_pin: !PB11
enable_pin: !PA8
microsteps: 16
rotation_distance: 22.23 #33.500
nozzle_diameter: 0.400
filament_diameter: 1.750
heater_pin: PC5
sensor_type: ATC Semitec 104NT-4-R025H42G
sensor_pin: PA1
control: pid
pid_Kp: 21.527
pid_Ki: 1.063
pid_Kd: 108.982
min_temp: 0
max_temp: 250

[tmc2209 extruder]
uart_pin: PB2
run_current: 0.200 #0.7A Max
diag_pin: PC2


#[extruder1]
#step_pin: PB0
#dir_pin: PB1
#enable_pin: !PC4
#heater_pin: PA7
#sensor_pin: PA2
#...

#[tmc2209 extruder1]
#uart_pin: PA6
#run_current: 0.600
#diag_pin:


#sensor_type:MAX31865
#sensor_pin: PA4
#spi_bus: spi1
#rtd_nominal_r: 100
#rtd_reference_r: 430
#rtd_num_of_wires: 2

#[filament_switch_sensor material_0]
#switch_pin: PC2



[heater_bed]
heater_pin: PA5
sensor_type: Generic 3950
sensor_pin: PA0
control: pid
smooth_time: 3.0
pid_kp: 68.453
pid_ki: 2.749
pid_kd: 426.122
min_temp: 0
max_temp: 110

[fan]
pin: PA4

#[heater_fan fan1]
#pin: PA3

#[heater_fan SoC_fan]
#pin: CB1: gpio79
#pin: RPI: gpio26

[board_pins]
aliases:
    # EXP1 header
    EXP1_1=PD5, EXP1_3=PB3, EXP1_5=PB5, EXP1_7=PB7, EXP1_9=<GND>,
    EXP1_2=PD4,  EXP1_4=PD6, EXP1_6=PB4, EXP1_8=PB6, EXP1_10=<5V>,
    # EXP2 header
    EXP2_1=PB14, EXP2_3=PB8, EXP2_5=PC10, EXP2_7=PC12,  EXP2_9=<GND>,
    EXP2_2=PB13, EXP2_4=PB9, EXP2_6=PB15, EXP2_8=<RST>, EXP2_10=<NC>

# See the sample-lcd.cfg file for definitions of common LCD displays.

#[bltouch]
#sensor_pin: PC13
#control_pin: PC15

# Proximity switch
#[probe]
#pin: PC15

#[neopixel my_neopixel1]
#pin: PC11

#[neopixel my_neopixel2]
#pin: PC14

#[adxl345]
#cs_pin: PC0
#spi_bus: spi2

#####################################################################
#   PZ Probe
#####################################################################

[probe] ## Other parameters in config.cfg
pin: !PC3
x_offset: 0.0
y_offset: 0.0
z_offset: 0.0
speed: 5.0 #   Speed (in mm/s) of the Z axis when probing. The default is 5mm/s.
samples: 2
sample_retract_dist: 3.0
samples_tolerance_retries: 1
lift_speed: 10
activate_gcode:
    G4 P200 ;Wait 200ms
    SET_TMC_CURRENT STEPPER=stepper_z CURRENT=0.2
deactivate_gcode:
    {% set run_current = printer.configfile.config['tmc2209 stepper_z'].run_current | float %}
    SET_TMC_CURRENT STEPPER=stepper_z CURRENT={run_current}
