jaysuk/RepRap-Huxley-Vector3D-Edition/(commit log)

2026-03-26 Photos, BOM, Drawings added
    [RepRap Huxley BOM GitHub V1.1.xlsx, printer.cfg]
2026-03-26 Added STEP files
    [RepRapPro Huxley Assembled.step]
